jonathanpod/signal_analyser/adc.kicad_sch

## KiCad design adc.kicad_sch (2022-04-25)

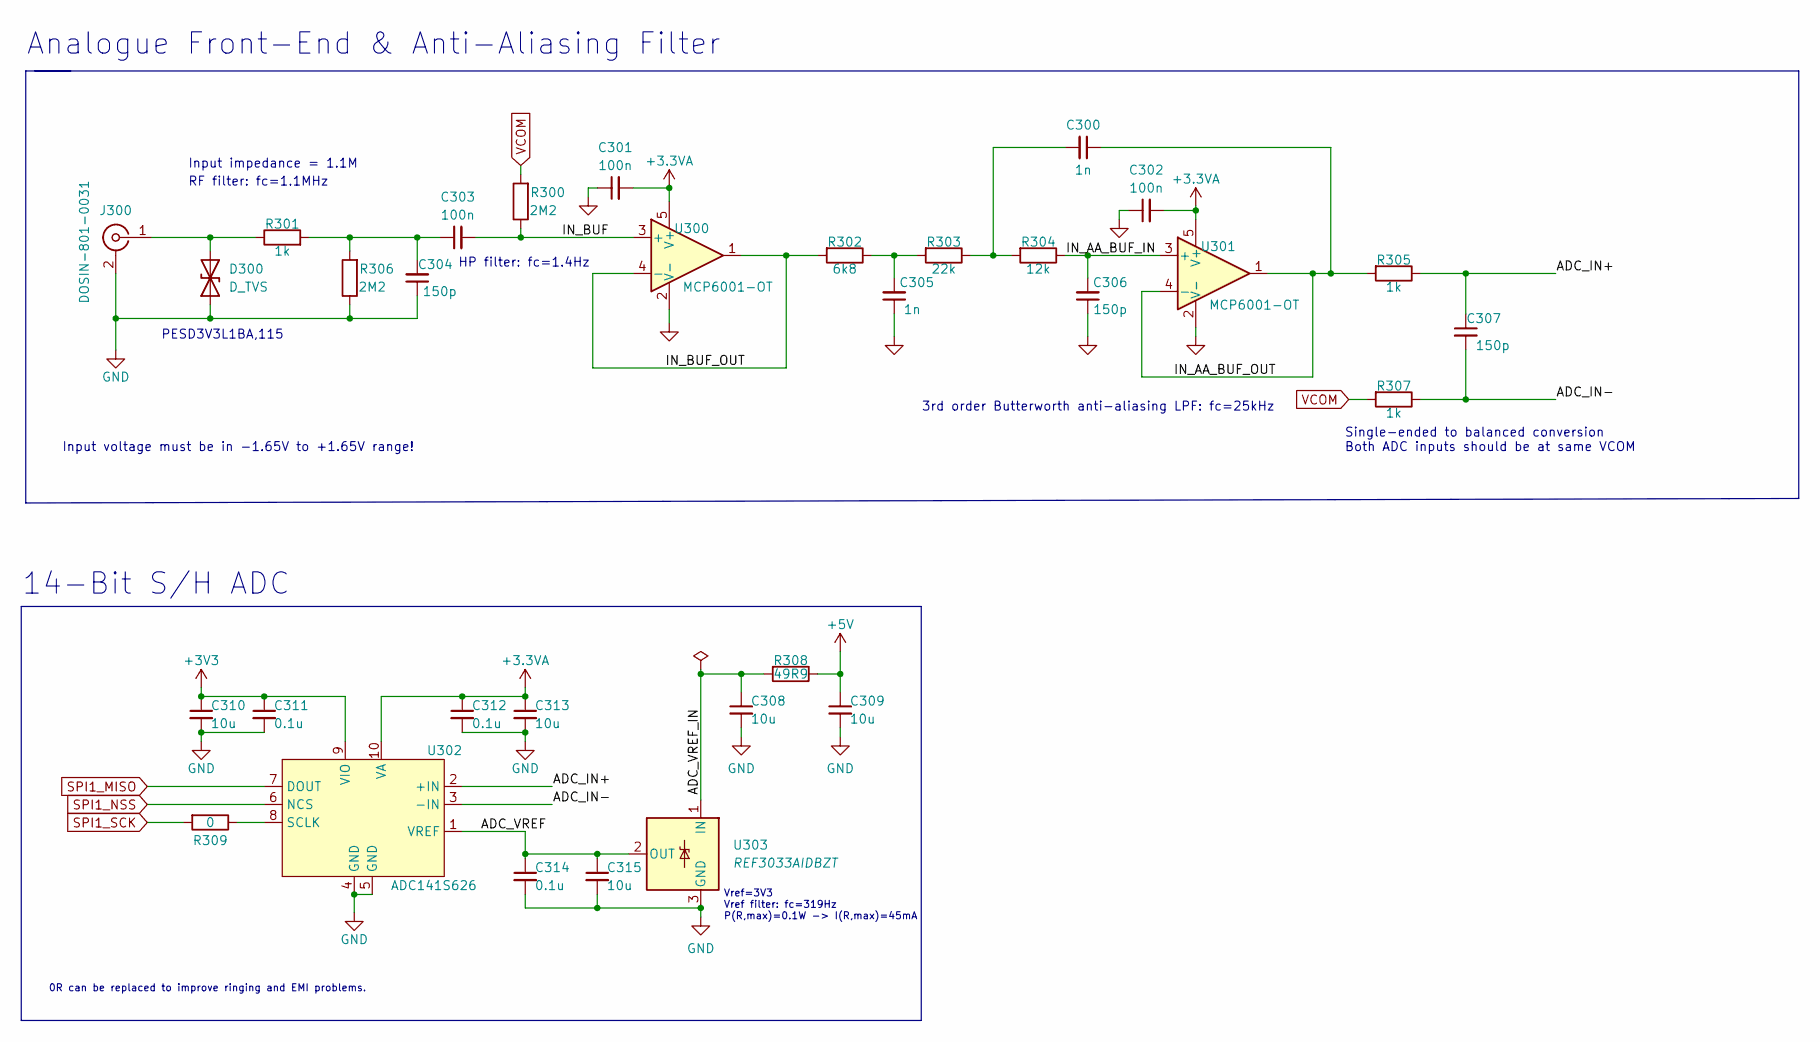
[picture p2: schematic adc.kicad_sch]

Parts:
C300, C305: 1n; C_0402_1005Metric
C301, C302, C303: 100n; C_0402_1005Metric
C304, C306, C307: 150p; C_0402_1005Metric
C308, C309, C310, C313, C315: 10u; C_0603_1608Metric
C311, C312, C314: 0.1u; C_0402_1005Metric
D300: D_TVS; D_SOD-323
J300: DOSIN-801-0031; BNC_Amphenol_031-6575_Horizontal
R300, R306: 2M2; R_0402_1005Metric
R301, R305, R307: 1k; R_0402_1005Metric
R302: 6k8; R_0402_1005Metric
R303: 22k; R_0402_1005Metric
R304: 12k; R_0402_1005Metric
R308: 49R9; R_0402_1005Metric
R309: 0; R_0402_1005Metric
U300, U301: MCP6001-OT; SOT-23-5
U302: ADC141S626; SOIC-10
U303: REF3033AIDBZT; SOT-23

Connections:
+3.3VA: C301.2, C302.2, C312.1, C313.1, U300.5 (V+), U301.5 (V+), U302.10 (VA)
+3V3: C310.1, C311.1, U302.9 (VIO)
+5V: C309.1, R308.1
ADC_IN+: C307.1, R305.1, U302.2 (+IN)
ADC_IN-: C307.2, R307.1, U302.3 (-IN)
ADC_VREF: C314.1, C315.1, U302.1 (VREF), U303.2 (OUT)
ADC_VREF_IN: C308.1, R308.2, U303.1 (IN)
GND: C301.1, C302.1, C304.1, C305.1, C306.1, C308.2, C309.2, C310.2, C311.2, C312.2, C313.2, C314.2, C315.2, D300.1 (A1), J300.2 (Ext), R306.1, U300.2 (V-), U301.2 (V-), U302.4 (GND), U302.5 (GND), U303.3 (GND)
IN_AA_BUF_IN: C306.2, R304.1, U301.3 (+)
IN_AA_BUF_OUT: C300.1, R305.2, U301.1, U301.4 (-)
IN_BUF: C303.2, R300.1, U300.3 (+)
IN_BUF_OUT: R302.2, U300.1, U300.4 (-)
unnamed: C300.2, R303.1, R304.2
unnamed: C303.1, C304.2, R301.2, R306.2
unnamed: C305.2, R302.1, R303.2
unnamed: D300.2 (A2), J300.1 (In), R301.1
unnamed: R309.1, U302.8 (SCLK)
SPI1_MISO: U302.7 (DOUT)
SPI1_NSS: U302.6 (NCS)
SPI1_SCK: R309.2
VCOM: R300.2, R307.2

Notes on the sheet:
Vref=3V3 Vref filter: fc=319Hz P(R,max)=0.1W -> I(R,max)=45mA
Single-ended to balanced conversion Both ADC inputs should be at same VCOM
Input voltage must be in -1.65V to +1.65V range!
3rd order Butterworth anti-aliasing LPF: fc=25kHz
RF filter: fc=1.1MHz
PESD3V3L1BA,115
0R can be replaced to improve ringing and EMI problems.
14-Bit S/H ADC
Input impedance = 1.1M
Analogue Front-End & Anti-Aliasing Filter
HP filter: fc=1.4Hz
