jonathanpod/signal_analyser/dac_sch.kicad_sch

## KiCad design dac_sch.kicad_sch (2022-04-25)

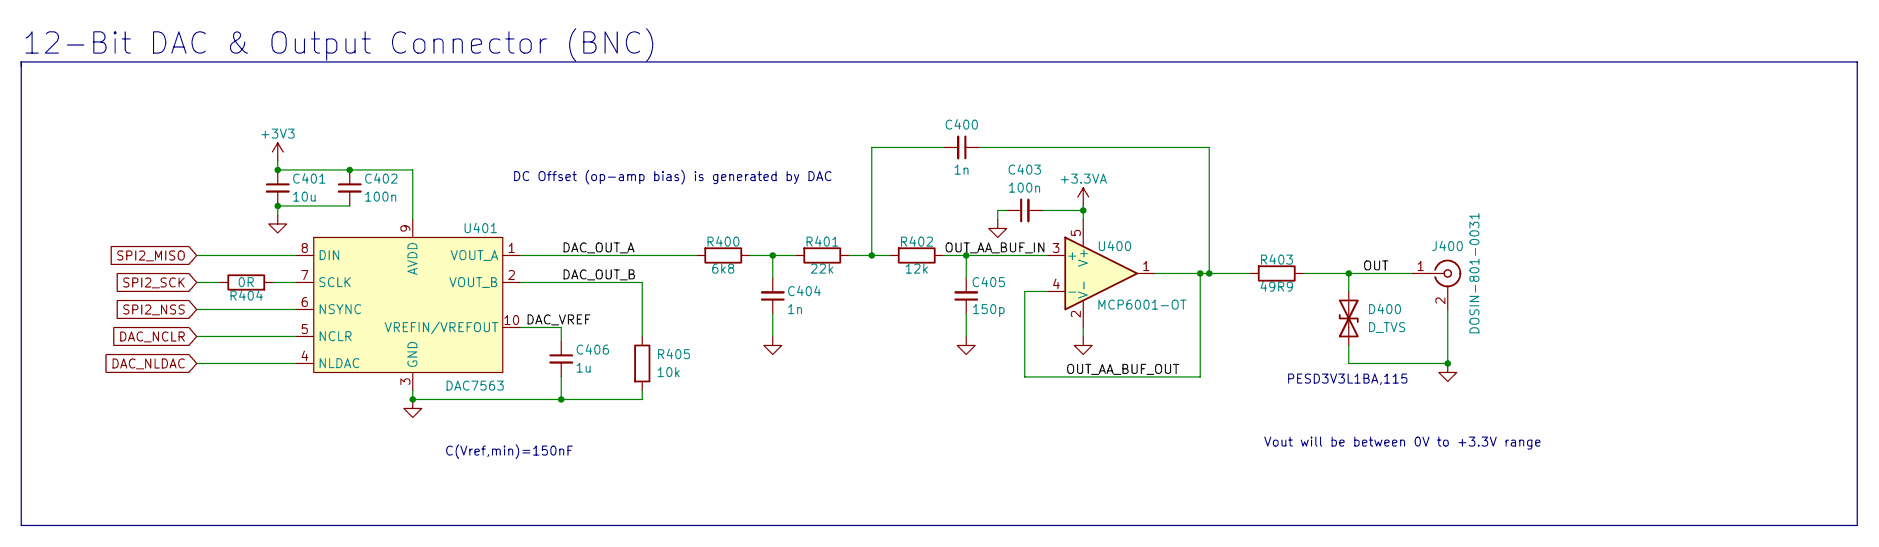
[picture p3: schematic dac_sch.kicad_sch]

Parts:
C400, C404: 1n; C_0402_1005Metric
C401: 10u; C_0603_1608Metric
C402, C403: 100n; C_0402_1005Metric
C405: 150p; C_0402_1005Metric
C406: 1u; C_0603_1608Metric
D400: D_TVS; D_SOD-323
J400: DOSIN-801-0031; BNC_Amphenol_031-6575_Horizontal
R400: 6k8; R_0402_1005Metric
R401: 22k; R_0402_1005Metric
R402: 12k; R_0402_1005Metric
R403: 49R9; R_0402_1005Metric
R404: 0R; R_0402_1005Metric
R405: 10k; R_0402_1005Metric
U400: MCP6001-OT; SOT-23-5
U401: DAC7563; SOIC-10

Connections:
+3.3VA: C403.2, U400.5 (V+)
+3V3: C401.1, C402.1, U401.9 (AVDD)
DAC_NCLR: U401.5 (NCLR)
DAC_NLDAC: U401.4 (NLDAC)
DAC_OUT_A: R400.2, U401.1 (VOUT_A)
DAC_OUT_B: R405.1, U401.2 (VOUT_B)
DAC_VREF: C406.1, U401.10 (VREFIN/VREFOUT)
GND: C401.2, C402.2, C403.1, C404.1, C405.1, C406.2, D400.1 (A1), J400.2 (Ext), R405.2, U400.2 (V-), U401.3 (GND)
unnamed: C400.2, R401.1, R402.2
unnamed: C404.2, R400.1, R401.2
unnamed: R404.2, U401.7 (SCLK)
OUT: D400.2 (A2), J400.1 (In), R403.1
OUT_AA_BUF_IN: C405.2, R402.1, U400.3 (+)
OUT_AA_BUF_OUT: C400.1, R403.2, U400.1, U400.4 (-)
SPI2_MISO: U401.8 (DIN)
SPI2_NSS: U401.6 (NSYNC)
SPI2_SCK: R404.1

Notes on the sheet:
12-Bit DAC & Output Connector (BNC)
DC Offset (op-amp bias) is generated by DAC
C(Vref,min)=150nF
PESD3V3L1BA,115
Vout will be between 0V to +3.3V range
