jonathanpod/signal_analyser/mcu.kicad_sch

## KiCad design mcu.kicad_sch (2022-04-25)

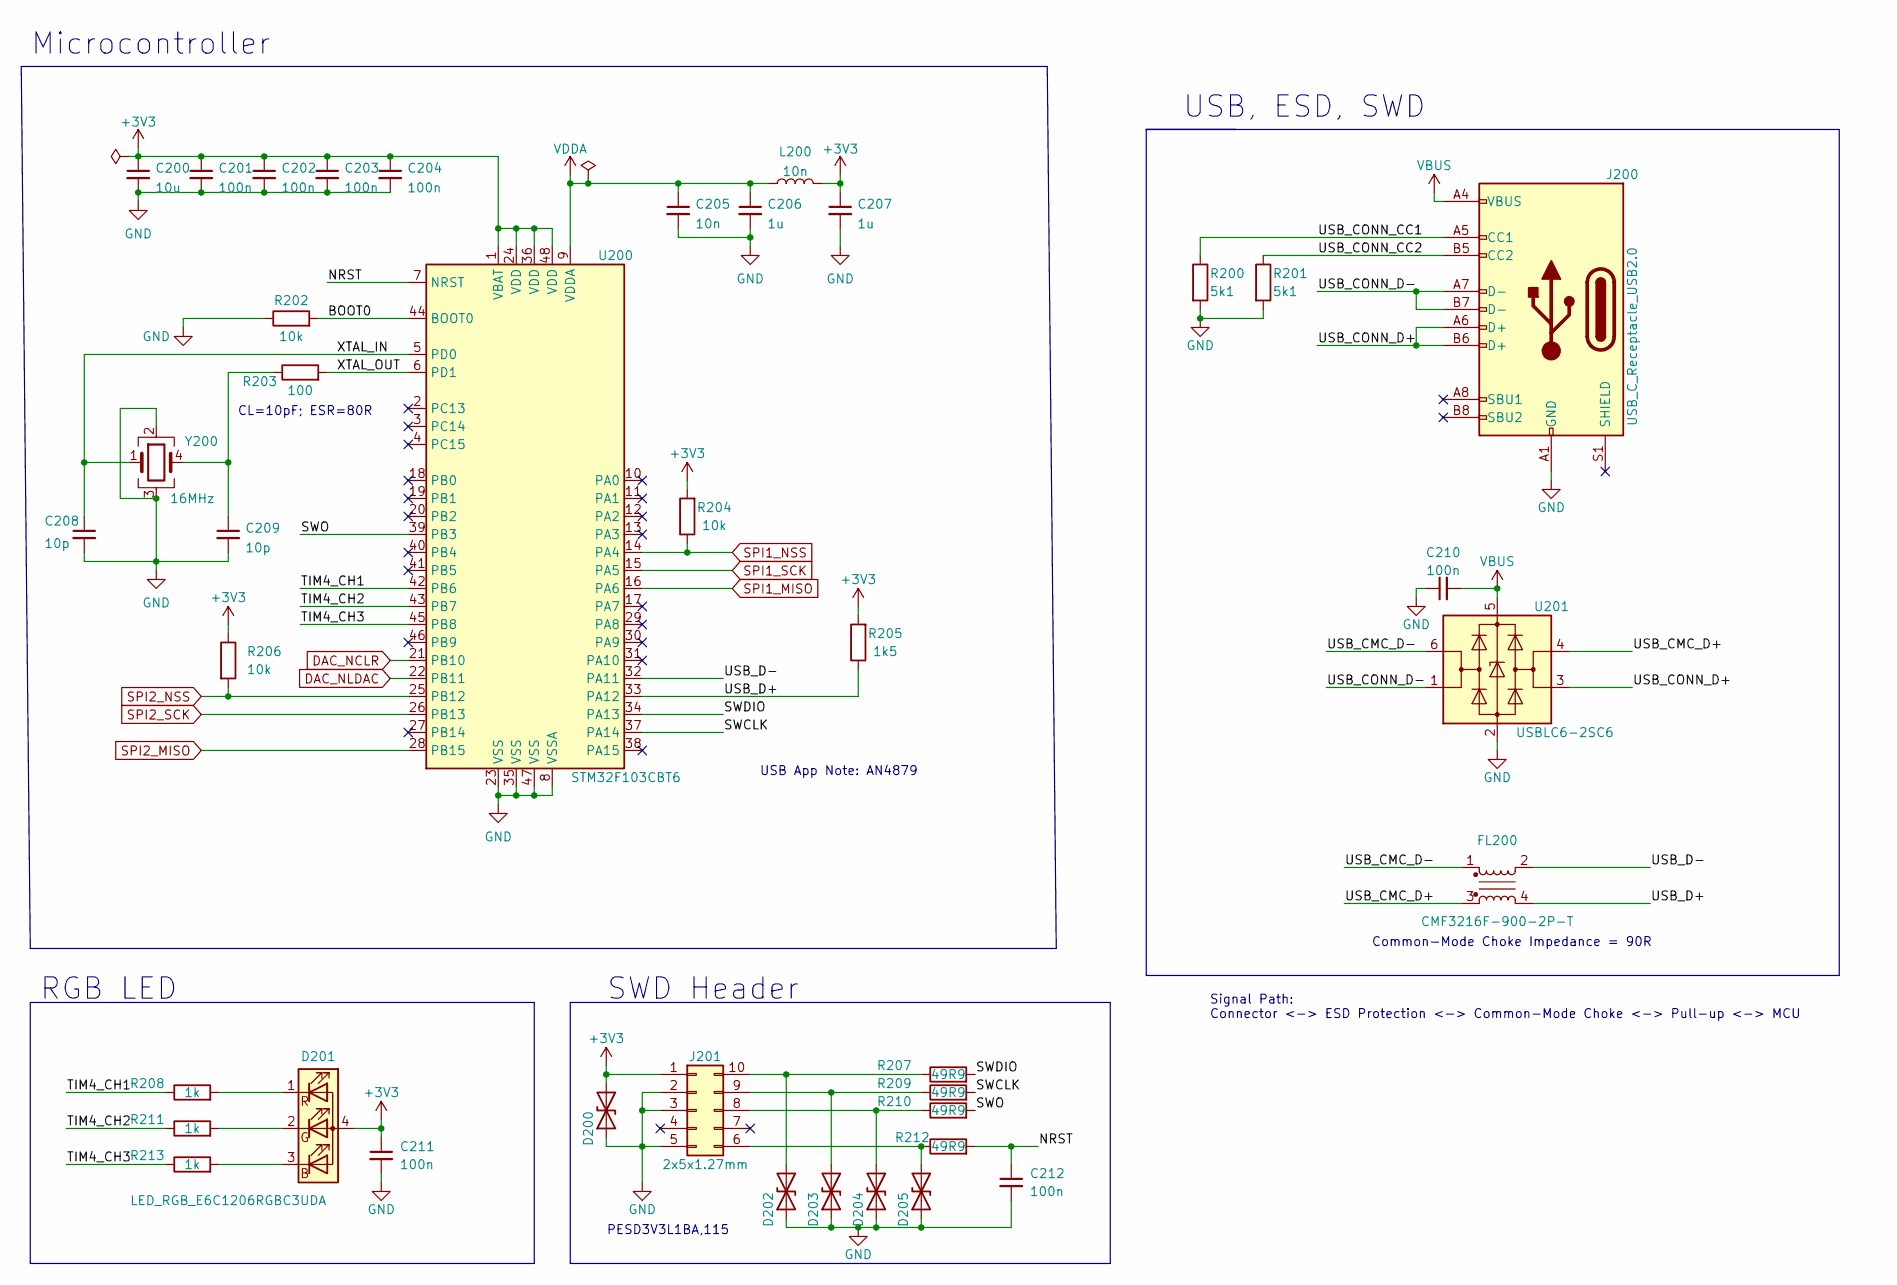
[picture p4: schematic mcu.kicad_sch]

Parts:
C200: 10u; C_0603_1608Metric
C201, C202, C203, C204, C210, C211, C212: 100n; C_0402_1005Metric
C205: 10n; C_0402_1005Metric
C206, C207: 1u; C_0603_1608Metric
C208, C209: 10p; C_0402_1005Metric
D200, D202, D203, D204, D205: D_TVS; D_SOD-323
D201: LED_RGB_E6C1206RGBC3UDA; LED_Cree-PLCC4_2x2mm_CW
FL200: CMF3216F-900-2P-T; Choke_Schaffner_RN102-04-14.0x14.0mm
J200: USB_C_Receptacle_USB2.0; USB_C_Receptacle_HRO_TYPE-C-31-M-12
J201: 2x5x1.27mm; PinHeader_2x05_P1.27mm_Vertical_SMD
L200: 10n; L_0402_1005Metric
R200, R201: 5k1; R_0402_1005Metric
R202, R204, R206: 10k; R_0402_1005Metric
R203: 100; R_0402_1005Metric
R205: 1k5; R_0402_1005Metric
R207, R209, R210, R212: 49R9; R_0402_1005Metric
R208, R211, R213: 1k; R_0402_1005Metric
U200: STM32F103CBT6; LQFP-48_7x7mm_P0.5mm
U201: USBLC6-2SC6; SOT-23-6
Y200: 16MHz; Crystal_SMD_3225-4Pin_3.2x2.5mm

Connections:
+3V3: C200.1, C201.1, C202.1, C203.1, C204.1, C207.1, C211.1, D200.2 (A2), D201.4 (A), J201.1, L200.2, R204.2, R205.2, R206.1, U200.1 (VBAT), U200.24 (VDD), U200.36 (VDD), U200.48 (VDD)
BOOT0: R202.2, U200.44 (BOOT0)
DAC_NCLR: U200.21 (PB10)
DAC_NLDAC: U200.22 (PB11)
GND: C200.2, C201.2, C202.2, C203.2, C204.2, C205.2, C206.2, C207.2, C208.2, C209.2, C210.1, C211.2, C212.2, D200.1 (A1), D202.1 (A1), D203.1 (A1), D204.1 (A1), D205.1 (A1), J200.A1 (GND), J200.A12 (GND), J200.B1 (GND), J200.B12 (GND), J201.2, J201.3, J201.5, R200.2, R201.2, R202.1, U200.8 (VSSA), U200.23 (VSS), U200.35 (VSS), U200.47 (VSS), U201.2 (GND), Y200.2, Y200.3
NRST: C212.1, R212.2, U200.7 (NRST)
unnamed: C209.1, R203.1, Y200.4
unnamed: D201.1 (RK), R208.2
unnamed: D201.2 (GK), R211.2
unnamed: D201.3 (BK), R213.2
unnamed: D202.2 (A2), J201.10, R207.1
unnamed: D203.2 (A2), J201.9, R209.1
unnamed: D204.2 (A2), J201.8, R210.1
unnamed: D205.2 (A2), J201.6, R212.1
SPI1_MISO: U200.16 (PA6)
SPI1_NSS: R204.1, U200.14 (PA4)
SPI1_SCK: U200.15 (PA5)
SPI2_MISO: U200.28 (PB15)
SPI2_NSS: R206.2, U200.25 (PB12)
SPI2_SCK: U200.26 (PB13)
SWCLK: R209.2, U200.37 (PA14)
SWDIO: R207.2, U200.34 (PA13)
SWO: R210.2, U200.39 (PB3)
TIM4_CH1: R208.1, U200.42 (PB6)
TIM4_CH2: R211.1, U200.43 (PB7)
TIM4_CH3: R213.1, U200.45 (PB8)
USB_CMC_D+: FL200.3, U201.4 (I/O2)
USB_CMC_D-: FL200.1, U201.6 (I/O1)
USB_CONN_CC1: J200.A5 (CC1), R200.1
USB_CONN_CC2: J200.B5 (CC2), R201.1
USB_CONN_D+: J200.A6 (D+), J200.B6 (D+), U201.3 (I/O2)
USB_CONN_D-: J200.A7 (D-), J200.B7 (D-), U201.1 (I/O1)
USB_D+: FL200.4, R205.1, U200.33 (PA12)
USB_D-: FL200.2, U200.32 (PA11)
VBUS: C210.2, J200.A4 (VBUS), J200.A9 (VBUS), J200.B4 (VBUS), J200.B9 (VBUS), U201.5 (VBUS)
VDDA: C205.1, C206.1, L200.1, U200.9 (VDDA)
XTAL_IN: C208.1, U200.5 (PD0), Y200.1
XTAL_OUT: R203.2, U200.6 (PD1)

Notes on the sheet:
Microcontroller
PESD3V3L1BA,115
USB, ESD, SWD
SWD Header
RGB LED
Common-Mode Choke Impedance = 90R
CL=10pF; ESR=80R
Signal Path: Connector <-> ESD Protection <-> Common-Mode Choke <-> Pull-up <-> MCU
USB App Note: AN4879
