jonathanpod/signal_analyser/power_supply.kicad_sch

## KiCad design power_supply.kicad_sch (2022-04-25)

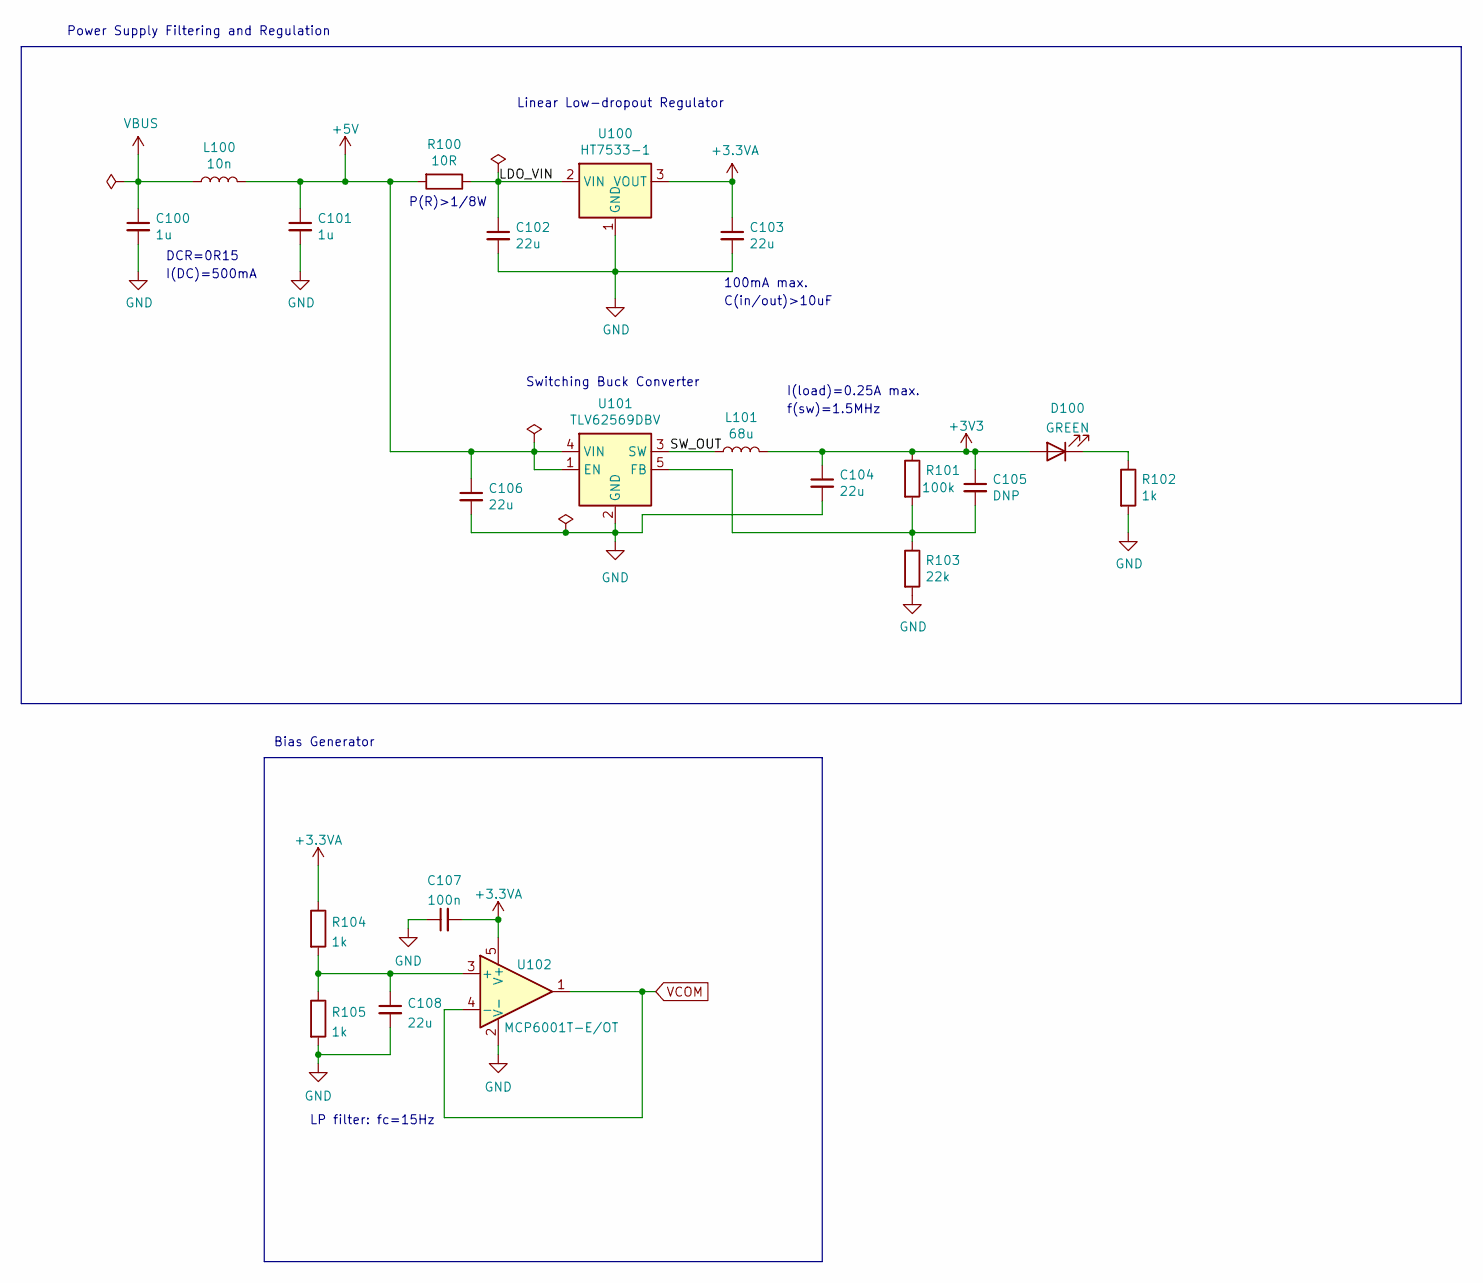
[picture p5: schematic power_supply.kicad_sch]

Parts:
C100, C101: 1u; C_0603_1608Metric
C102, C103, C104, C106, C108: 22u; C_0805_2012Metric
C105: DNP; C_0402_1005Metric
C107: 100n; C_0402_1005Metric
D100: GREEN; LED_0603_1608Metric
L100: 10n; L_0402_1005Metric
L101: 68u; L_0402_1005Metric
R100: 10R; R_0805_2012Metric
R101: 100k; R_0402_1005Metric
R102, R104, R105: 1k; R_0402_1005Metric
R103: 22k; R_0402_1005Metric
U100: HT7533-1; SOT-89-3
U101: TLV62569DBV; SOT-23-5
U102: MCP6001T-E/OT; SOT-23-5

Connections:
+3.3VA: C103.1, C107.2, R104.1, U100.3 (VOUT), U102.5 (V+)
+3V3: C104.1, C105.1, D100.2 (A), L101.2, R101.1
+5V: C101.1, C106.1, L100.2, R100.2, U101.1 (EN), U101.4 (VIN)
GND: C100.2, C101.2, C102.2, C103.2, C104.2, C106.2, C107.1, C108.2, R102.2, R103.2, R105.2, U100.1 (GND), U101.2 (GND), U102.2 (V-)
LDO_VIN: C102.1, R100.1, U100.2 (VIN)
unnamed: C105.2, R101.2, R103.1, U101.5 (FB)
unnamed: C108.1, R104.2, R105.1, U102.3 (+)
unnamed: D100.1 (K), R102.1
SW_OUT: L101.1, U101.3 (SW)
VBUS: C100.1, L100.1
VCOM: U102.1, U102.4 (-)

Notes on the sheet:
C(in/out)>10uF
100mA max.
Switching Buck Converter
f(sw)=1.5MHz
DCR=0R15
P(R)>1/8W
Power Supply Filtering and Regulation
LP filter: fc=15Hz
I(load)=0.25A max.
Linear Low-dropout Regulator
Bias Generator
I(DC)=500mA
