jonathanpod/signal_analyser/(commit log)

2022-02-05 Added files. Power supply done.
    [mcu.kicad_sch, power_supply.kicad_sch, power_supply.sch, signal_analyser.kicad_pcb, signal_analyser.kicad_sch, signal_analyser.sch]
2022-02-26 Added crystal oscillator.
    [mcu.kicad_sch, signal_analyser.kicad_sch]
2022-02-26 Completed MCU circuitry
    [mcu.kicad_sch, signal_analyser.kicad_sch]
2022-02-26 Completed USB Type C connection.
    [mcu.kicad_sch, signal_analyser.kicad_sch]
2022-02-26 Completed SWD header and RGB LED schematic
    [mcu.kicad_sch, signal_analyser.kicad_sch]
2022-03-05 Added 14-bit s/h ADC
    [adc.kicad_sch, mcu.kicad_sch, signal_analyser.kicad_sch]
2022-03-06 Completed ADC, DAC, Analogue In, and Analogue Out
    [adc.kicad_sch, dac_sch.kicad_sch, signal_analyser.kicad_sch]
2022-03-07 ERC valid.
    [adc.kicad_sch, dac_sch.kicad_sch, mcu.kicad_sch, power_supply.kicad_sch, signal_analyser.kicad_sch]
2022-04-25 Assigned Footprints and Set up board specifications.
    [User Library-DGS0010A.STEP, adc.kicad_sch, dac_sch.kicad_sch, mcu.kicad_sch, power_supply.kicad_sch, signal_analyser.kicad_pcb, signal_analyser.kicad_sch]
